blahblahson/funcoid1/README

# FUNCOID1 - a 65C02 computer

This repository contains the FUNCOID1 design files for KiCad 5.
