blahblahson/funcoid1/funcoid1.kicad_pcb

## KiCad design funcoid1.kicad_pcb (2020-03-21)

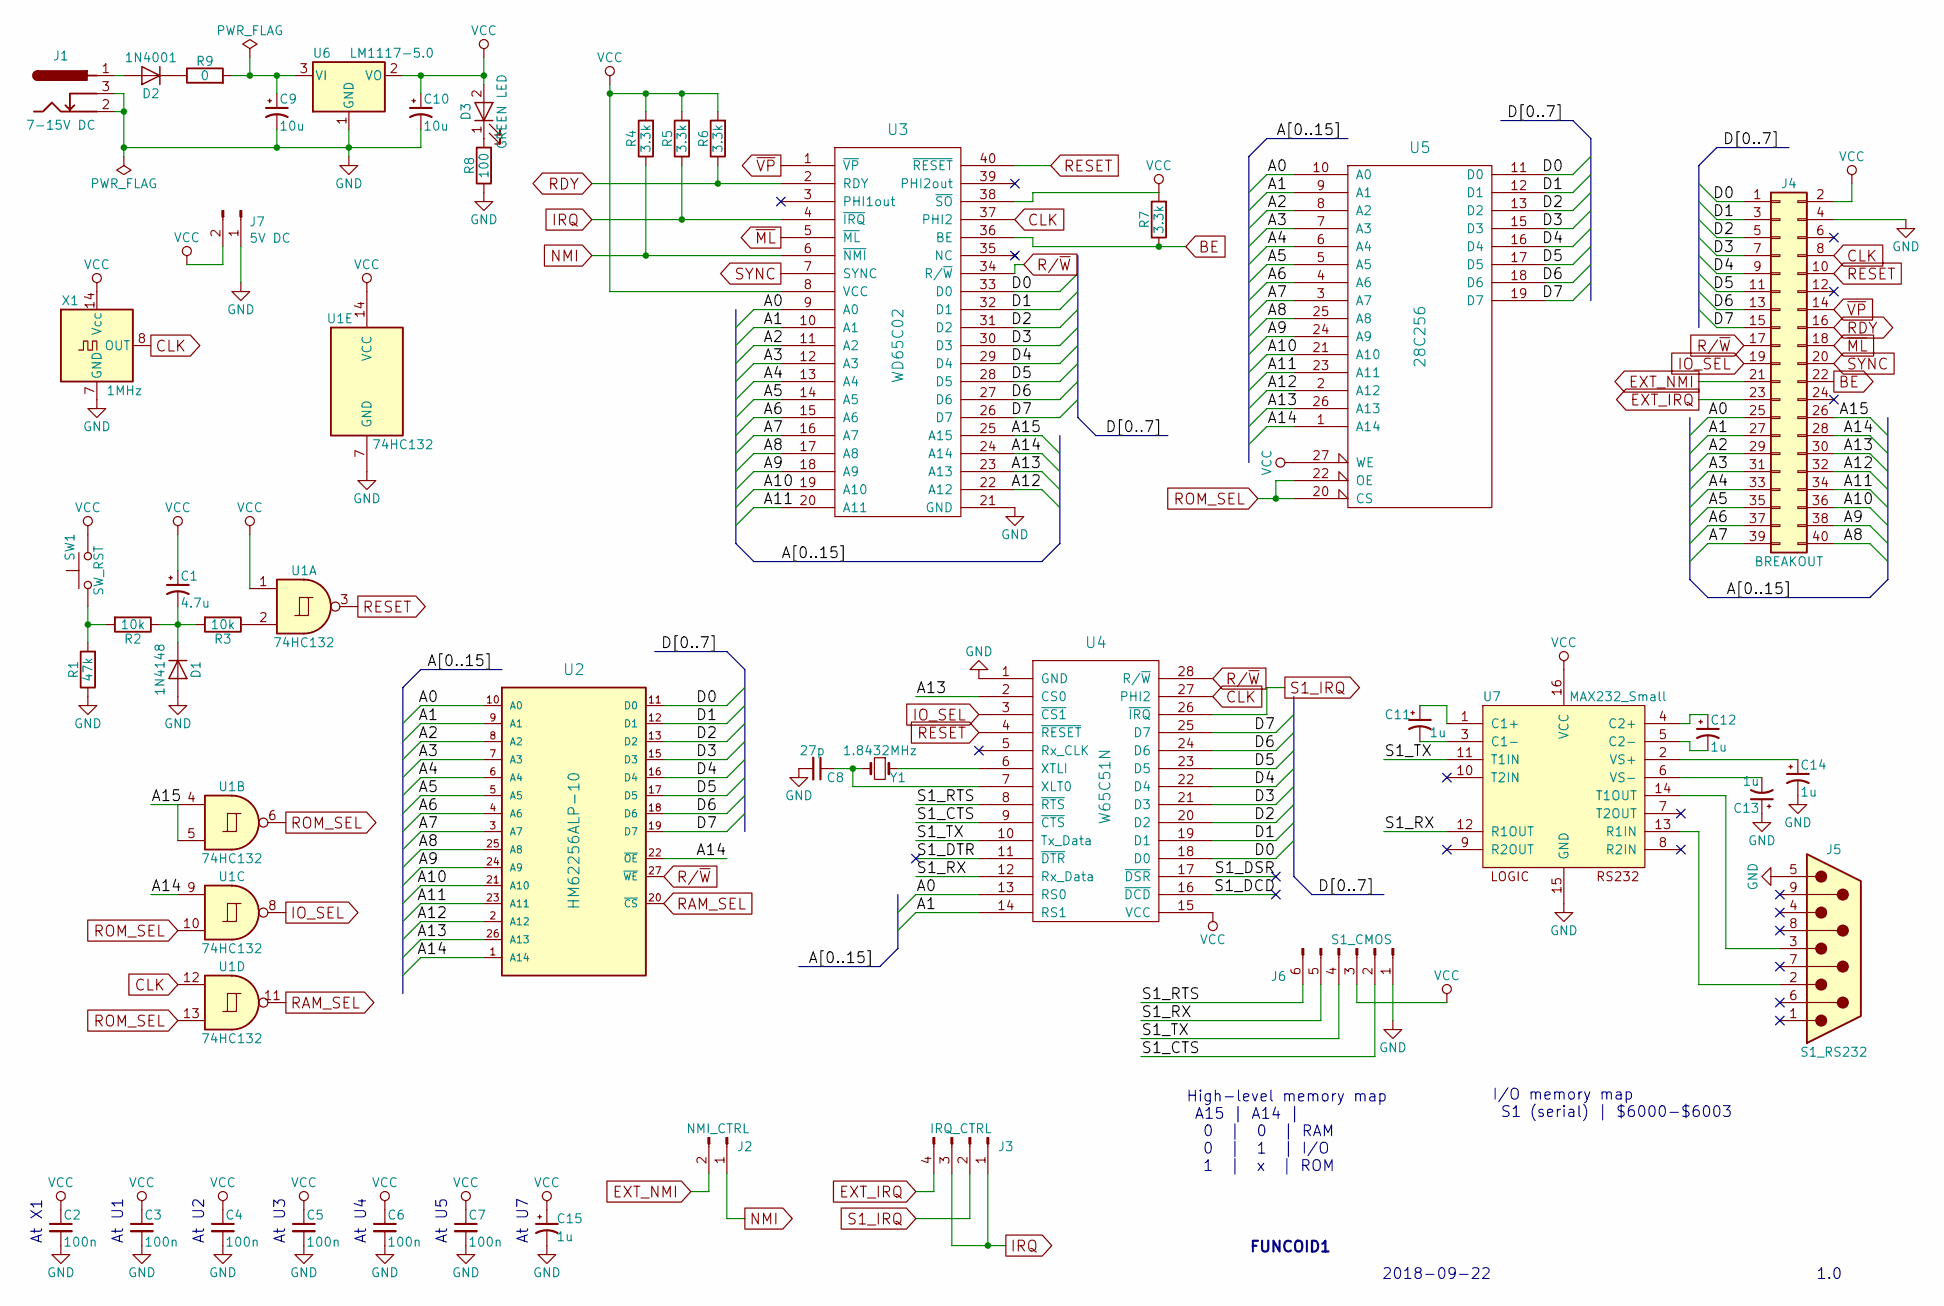
[picture p1: schematic funcoid1.sch]

Parts:
C1: 4.7u; CP_Radial_D5.0mm_P2.50mm
C2, C3, C4, C5, C6, C7: 100n; C_Disc_D5.0mm_W2.5mm_P5.00mm
C8: 27p; C_Disc_D5.0mm_W2.5mm_P5.00mm
C9, C10: 10u; C_Disc_D5.0mm_W2.5mm_P5.00mm
C11, C12, C13, C14, C15: 1u; C_Disc_D5.0mm_W2.5mm_P5.00mm
D1: 1N4148; D_DO-35_SOD27_P7.62mm_Horizontal
D2: 1N4001; D_DO-41_SOD81_P7.62mm_Horizontal
D3: GREEN LED; LED_D3.0mm
J1: 7-15V DC; BARREL_JACK
J2: NMI_CTRL; Pin_Header_Straight_1x02_Pitch2.54mm
J3: IRQ_CTRL; Pin_Header_Straight_1x04_Pitch2.54mm
J4: BREAKOUT; IDC-Header_2x20_Pitch2.54mm_Straight
J5: S1_RS232; DSUB-9_Female_Horizontal_Pitch2.77x2.84mm_EdgePinOffset7.70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
J6: S1_CMOS; PinHeader_1x06_P2.54mm_Horizontal
J7: 5V DC; PinHeader_1x02_P2.54mm_Vertical
R1: 47k; R_Axial_DIN0207_L6.3mm_D2.5mm_P7.62mm_Horizontal
R2, R3: 10k; R_Axial_DIN0207_L6.3mm_D2.5mm_P7.62mm_Horizontal
R4, R5, R6, R7: 3.3k; R_Axial_DIN0207_L6.3mm_D2.5mm_P7.62mm_Horizontal
R8: 100; R_Axial_DIN0207_L6.3mm_D2.5mm_P7.62mm_Horizontal
R9: 0; R_Axial_DIN0207_L6.3mm_D2.5mm_P7.62mm_Horizontal
SW1: SW_RST; SW_PUSH_6mm
U1: 74HC132; DIP-14_W7.62mm
U2: HM62256ALP-10; DIP-28_W15.24mm
U3: WD65C02; DIP-40_W15.24mm
U4: W65C51N; DIP-28_W15.24mm
U5: 28C256; DIP-28_W15.24mm
U6: LM1117-5.0; TO-220
U7: MAX232_Small; DIP-16_W7.62mm_Socket
X1: 1MHz; Oscillator_DIP-14
Y1: 1.8432MHz; Crystal_HC49-U_Vertical

Connections:
/A0: J4.25, U2.10 (A0), U3.9 (A0), U4.13 (RS0), U5.10 (A0)
/A1: J4.27, U2.9 (A1), U3.10 (A1), U4.14 (RS1), U5.9 (A1)
/A2: J4.29, U2.8 (A2), U3.11 (A2), U5.8 (A2)
/A3: J4.31, U2.7 (A3), U3.12 (A3), U5.7 (A3)
/A4: J4.33, U2.6 (A4), U3.13 (A4), U5.6 (A4)
/A5: J4.35, U2.5 (A5), U3.14 (A5), U5.5 (A5)
/A6: J4.37, U2.4 (A6), U3.15 (A6), U5.4 (A6)
/A7: J4.39, U2.3 (A7), U3.16 (A7), U5.3 (A7)
/A8: J4.40, U2.25 (A8), U3.17 (A8), U5.25 (A8)
/A9: J4.38, U2.24 (A9), U3.18 (A9), U5.24 (A9)
/A10: J4.36, U2.21 (A10), U3.19 (A10), U5.21 (A10)
/A11: J4.34, U2.23 (A11), U3.20 (A11), U5.23 (A11)
/A12: J4.32, U2.2 (A12), U3.22 (A12), U5.2 (A12)
/A13: J4.30, U2.26 (A13), U3.23 (A13), U4.2 (CS0), U5.26 (A13)
/A14: J4.28, U1.9, U2.1 (A14), U2.22 (~OE), U3.24 (A14), U5.1 (A14)
/A15: J4.26, U1.4, U1.5, U3.25 (A15)
/D0: J4.1, U2.11 (D0), U3.33 (D0), U4.18 (D0), U5.11 (D0)
/D1: J4.3, U2.12 (D1), U3.32 (D1), U4.19 (D1), U5.12 (D1)
/D2: J4.5, U2.13 (D2), U3.31 (D2), U4.20 (D2), U5.13 (D2)
/D3: J4.7, U2.15 (D3), U3.30 (D3), U4.21 (D3), U5.15 (D3)
/D4: J4.9, U2.16 (D4), U3.29 (D4), U4.22 (D4), U5.16 (D4)
/D5: J4.11, U2.17 (D5), U3.28 (D5), U4.23 (D5), U5.17 (D5)
/D6: J4.13, U2.18 (D6), U3.27 (D6), U4.24 (D6), U5.18 (D6)
/D7: J4.15, U2.19 (D7), U3.26 (D7), U4.25 (D7), U5.19 (D7)
/S1_CTS: J6.2, U4.9 (~CTS)
/S1_DCD: U4.16 (~DCD)
/S1_DSR: U4.17 (~DSR)
/S1_DTR: U4.11 (~DTR)
/S1_RTS: J6.6, U4.8 (~RTS)
/S1_RX: J6.5, U4.12 (Rx_Data), U7.12 (R1OUT)
/S1_TX: J6.4, U4.10 (Tx_Data), U7.11 (T1IN)
BE: J4.22, R7.1, U3.36 (BE)
CLK: J4.8, U1.12, U3.37 (PHI2), U4.27 (PHI2), X1.8 (OUT)
EXT_IRQ: J3.4, J4.23
EXT_NMI: J2.2, J4.21
GND: C2.2, C3.2, C4.2, C5.2, C6.2, C7.2, C8.2, C9.2, C10.2, C13.1, C14.2, C15.2, D1.2 (A), J1.2, J1.3, J4.4, J5.5, J6.1, J7.1, R1.1, R8.1, U1.7 (GND), U2.14 (GND), U3.21 (GND), U4.1 (GND), U5.14 (GND), U6.1 (GND), U7.15 (GND), X1.7 (GND)
IO_SEL: J4.19, U1.8, U4.3 (~CS1)
IRQ: J3.1, J3.3, R5.1, U3.4 (~IRQ)
NMI: J2.1, R4.1, U3.6 (~NMI)
unnamed: C1.2, D1.1 (K), R2.1, R3.2
unnamed: C8.1, U4.7 (XLT0), Y1.2
unnamed: C9.1, R9.2, U6.3 (VI)
unnamed: C11.1, U7.1 (C1+)
unnamed: C11.2, U7.3 (C1-)
unnamed: C12.1, U7.4 (C2+)
unnamed: C12.2, U7.5 (C2-)
unnamed: C13.2, U7.6 (VS-)
unnamed: C14.1, U7.2 (VS+)
unnamed: D2.1 (K), R9.1
unnamed: D2.2 (A), J1.1
unnamed: D3.1 (K), R8.2
unnamed: J5.2, U7.13 (R1IN)
unnamed: J5.3, U7.14 (T1OUT)
unnamed: R1.2, R2.2, SW1.1
unnamed: R3.1, U1.2
unnamed: U4.6 (XTLI), Y1.1
R/~W: J4.17, U2.27 (~WE), U3.34 (R/~W), U4.28 (R/~W)
RAM_SEL: U1.11, U2.20 (~CS)
RDY: J4.16, R6.1, U3.2 (RDY)
RESET: J4.10, U1.3, U3.40 (~RESET), U4.4 (~RESET)
ROM_SEL: U1.6, U1.10, U1.13, U5.20 (CS), U5.22 (OE)
S1_IRQ: J3.2, U4.26 (~IRQ)
SYNC: J4.20, U3.7 (SYNC)
VCC: C1.1, C2.1, C3.1, C4.1, C5.1, C6.1, C7.1, C10.1, C15.1, D3.2 (A), J4.2, J6.3, J7.2, R4.2, R5.2, R6.2, R7.2, SW1.2, U1.1, U1.14 (VCC), U2.28 (VCC), U3.8 (VCC), U3.38 (~SO), U4.15 (VCC), U5.27 (WE), U5.28 (VCC), U6.2 (VO), U7.16 (VCC), X1.14 (Vcc)
~ML: J4.18, U3.5 (~ML)
~VP: J4.14, U3.1 (~VP)

Notes on the sheet:
At X1
At U1
At U2
At U3
At U4
At U5
High-level memory map A15 | A14 | 0 | 0 | RAM 0 | 1 | I/O 1 | x | ROM
FUNCOID1
2018-09-22
1.0
I/O memory map S1 (serial) | $6000-$6003
At U7

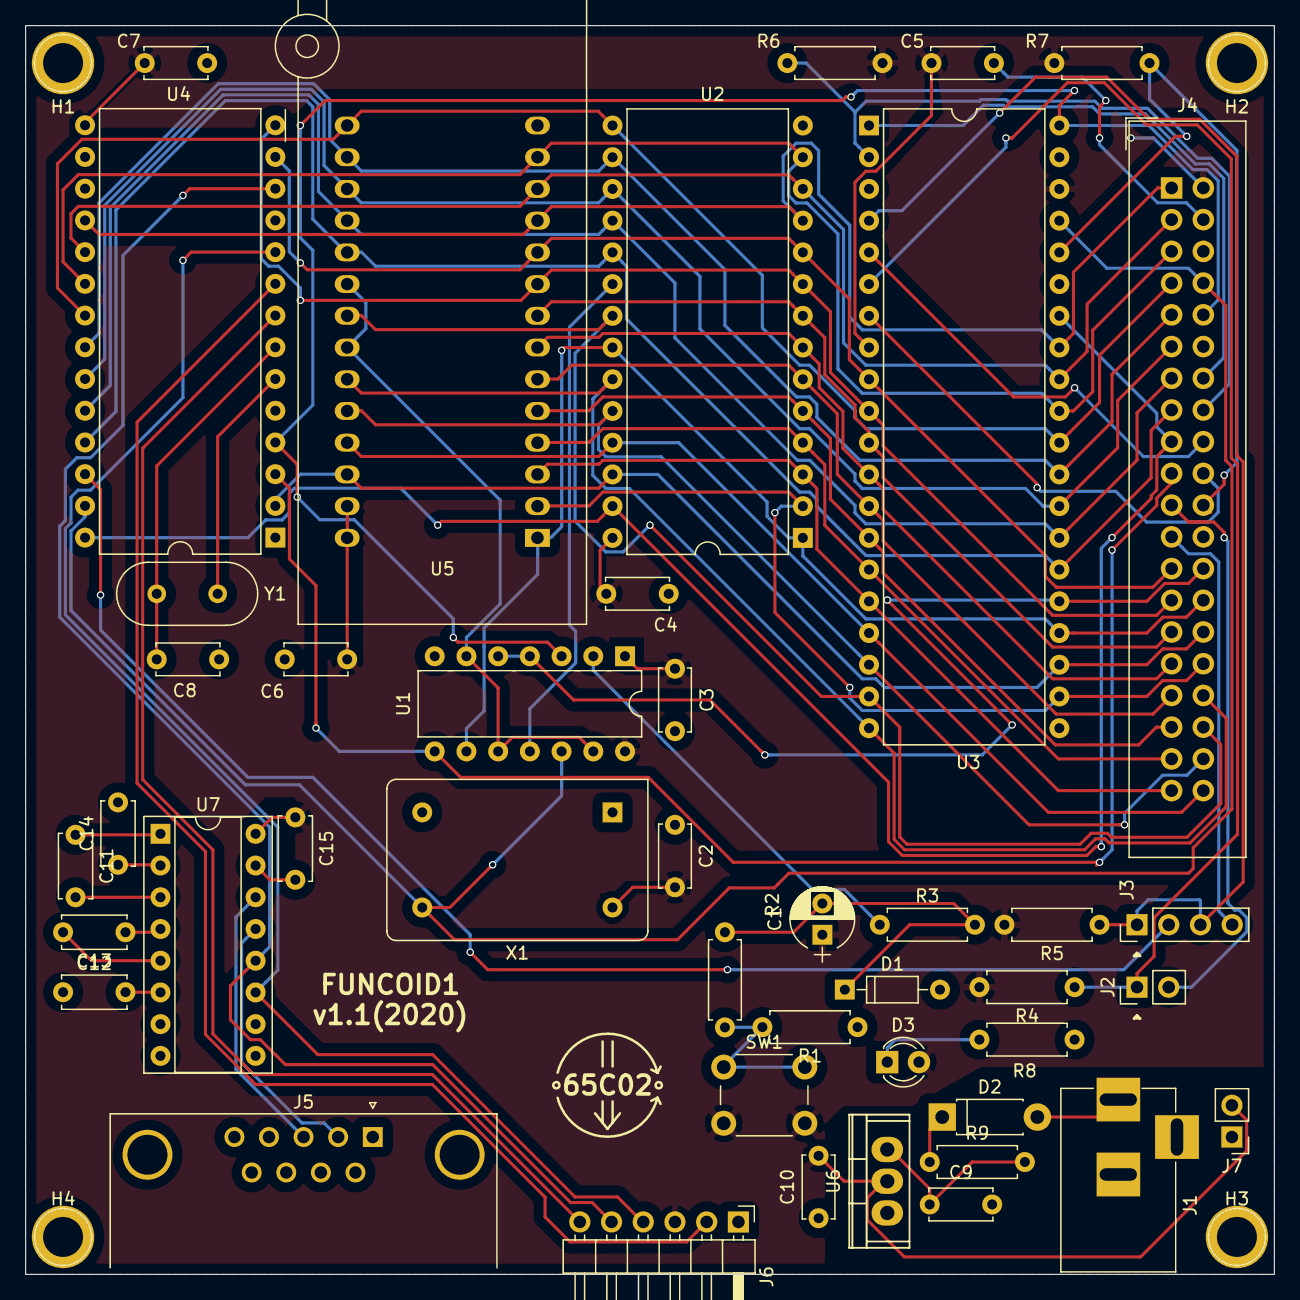
[picture p2: board funcoid1.kicad_pcb from above]

Board: 2 copper layers, 100.0 x 100.0 mm, 48 parts (0 on the bottom side), 63 nets.

Other parts of the board:
H1, H2, H3, H4: mounthole
