blahblahson/funcoid1/(commit log)

2019-05-17 FUNCOID1 first spin
    The schematic and PCB layout that correspond to the first spin of
    FUNCOID1. Gerber files were generated from this project and sent to
    DirtyPCBs (2018-09-22).
    [funcoid1.kicad_pcb, funcoid1.sch]
2019-10-13 Add additional KiCad lint to .gitignore
2019-10-15 Update to KiCad 5
    Not sure if all the right files are here. Fingers crossed.
    [funcoid1.sch]
2019-10-15 Use a ZIF footprint for U5 (EEPROM)
    ZIF sockets have feet that are slightly too wide to fit in a regular DIP
    footprint's drill holes. This caused me issues in the fist spin of
    FUNCOID1. Replace it with a ZIF footprint as was originally envisaged.
    I had to upgrade to KiCad 5 to make use of these new footprints. I made
    a custom derivative where the ZIF lever is facing the other way, but
    preserving the orientation of the pads.
    Some components had to be shifted around a little to avoid overlapping
    courtyards.
    [funcoid1.kicad_pcb]
2020-03-21 Add a MAX232 for proper RS-232 signalling
    Use a MAX232 to drive the signal on the DB9 connector, such that it is
    RS-232 compliant and will be understood by my VT510 terminal. Route the
    old 5V CMOS UART to a new 6-pin header for use with an FTDI.
    This change also moves the DB9 connector to the same edge as the barrel
    jack, which should make designing a box a little easier.
    Finally, do some general re-routing on the PCB layout.
    [funcoid1.kicad_pcb, funcoid1.sch]
